LUCASDUDUIT/ECE445/README.md

# ECE445 
A repository to replace the physical lab notebook for ECE445.

## Project Title: **Sturdy Smart Feeder**

### Team Members
Lucas Duduit
\
T'Andra Newby
\
Kevin Shi
