LUCASDUDUIT/ECE445/Notebooks/Lucas/IMG_2218.jpg

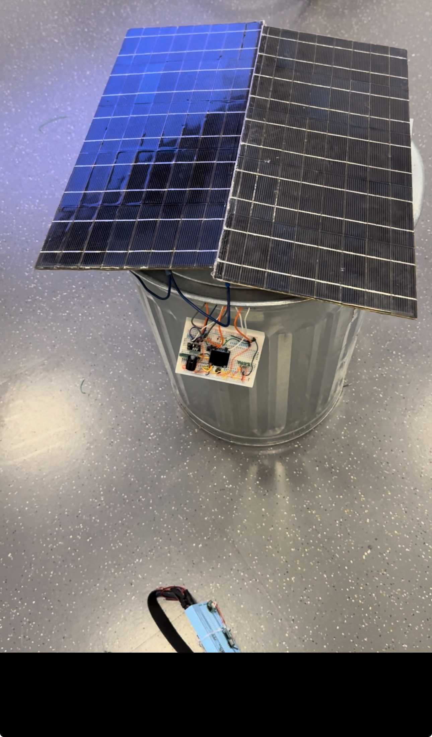
Notebooks/Lucas/IMG_2218.jpg
