LUCASDUDUIT/ECE445/Notebooks/T'Andra/20240418_151749.jpg

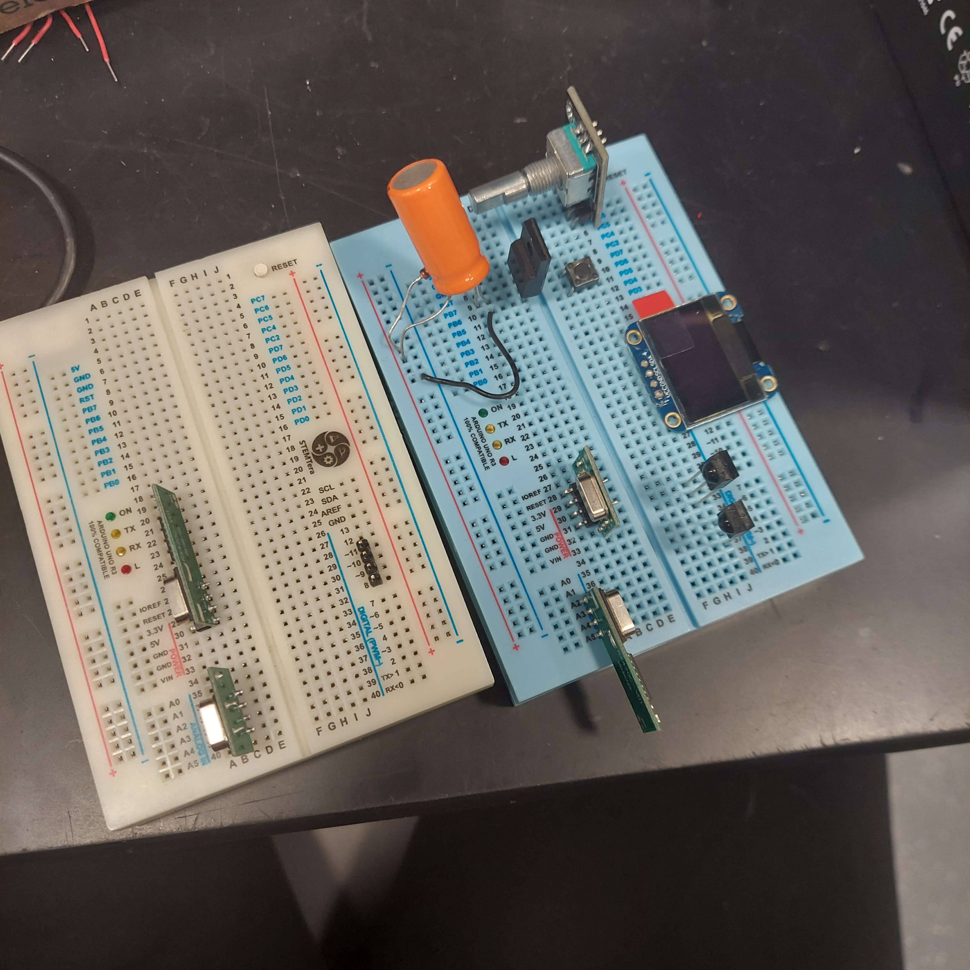
Notebooks/T'Andra/20240418_151749.jpg
