LUCASDUDUIT/ECE445/Notebooks/T'Andra/Screenshot 2024-05-02 122550.png

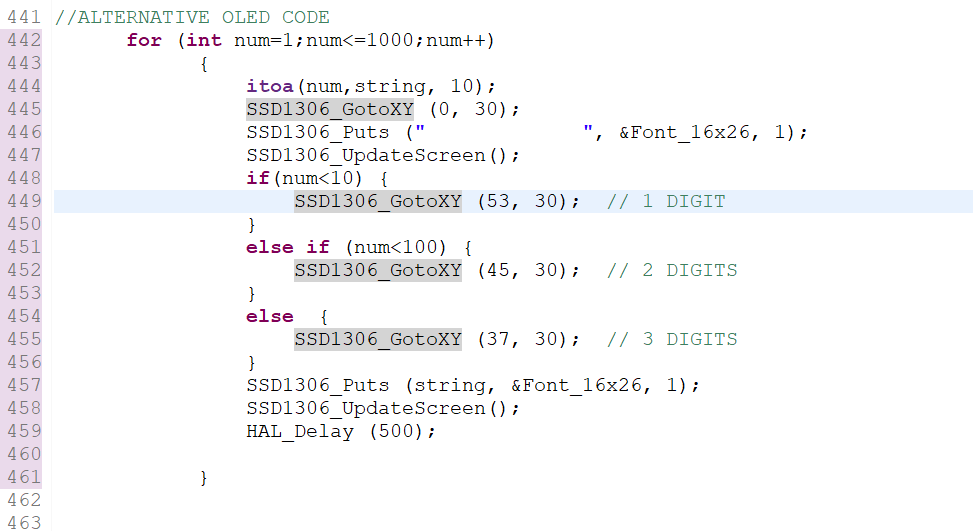
Notebooks/T'Andra/Screenshot 2024-05-02 122550.png
