LUCASDUDUIT/ECE445/Notebooks/T'Andra/practice_nucleo_project/Src/main.c

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
/* Includes ------------------------------------------------------------------*/
#include "main.h"

/* USER CODE BEGIN Includes */
#include <stdio.h>
#include <string.h>
#include <user_set.h>
#include "u8g2.h"
#include "stepper.h"
#include "rfid_feeder_transceiver.h"
#include "stm32f4xx_it.h"
#include "fonts.h"
#include "ssd1306.h"
#include "RH_ASK.h"

/* USER CODE END Includes */

/* USER CODE BEGIN PM */
extern I2C_HandleTypeDef hi2c1;

/* USER CODE END PM */

//I2C_HandleTypeDef hi2c1;

RTC_HandleTypeDef hrtc;

TIM_HandleTypeDef htim1;
TIM_HandleTypeDef htim2;
TIM_HandleTypeDef htim3;

UART_HandleTypeDef huart2;

/* USER CODE BEGIN PV */
//extern uint8_t u8x8_stm32_gpio_and_delay(u8x8_t *u8x8, uint8_t msg, uint8_t arg_int, void *arg_ptr);
//extern uint8_t u8x8_byte_stm32_hw_i2c(u8x8_t *u8x8, uint8_t msg, uint8_t arg_int, void *arg_ptr);
//extern uint8_t u8x8_byte_4wire_hw_i2c(u8x8_t *u8x8, uint8_t msg, uint8_t arg_int, void *arg_ptr);


//static u8g2_t u8g2;


int count, stepNumber, feed_amount, dispense_flag, run_time, run_, empty_flag;
uint8_t set_hour, set_min, init_hour, init_min;
uint8_t door_open_time_hour = 60;
uint8_t door_open_time_min = 60;
uint32_t lastFeederReceiveTime;
int feeding_times[];
int reset_state=0;
int close_flag =0;
int do_not_dispense =0;
int open_door_flag =0;
int run_motor=0;
//int rotationDirection;
//uint8_t TurnsDetected;



/* USER CODE END PV */

void SystemClock_Config(void);
static void MX_GPIO_Init(void);
static void MX_TIM1_Init(void);
static void MX_I2C1_Init(void);
static void MX_RTC_Init(void);
static void MX_TIM2_Init(void);
static void MX_TIM3_Init(void);
static void MX_USART2_UART_Init(void);
/**
  * @brief  The application entry point.
  * @retval int
  */
int main(void)
{
  /* MCU Configuration--------------------------------------------------------*/

  /* Reset of all peripherals, Initializes the Flash interface and the Systick. */
  HAL_Init();

  /* Configure the system clock */
  SystemClock_Config();

  /* Initialize all configured peripherals */
  MX_GPIO_Init();
  MX_TIM1_Init();
  MX_I2C1_Init();
  MX_RTC_Init();
  MX_TIM2_Init();
  MX_TIM3_Init();
  MX_USART2_UART_Init();
  /* USER CODE BEGIN 2 */

 // RH_ASK_Initialization();
  HAL_TIM_PWM_Start(&htim1,TIM_CHANNEL_1);
 // HAL_TIM_Base_Start(&htim1);//TIMER INITIALIZATION FOR THE DELAY ON MICRO SECONDS, stepper code
  HAL_TIM_Encoder_Start(&htim2, TIM_CHANNEL_ALL);//initialization for encoder first example
  HAL_GPIO_WritePin(GPIOA, GPIO_PIN_6, 0);
  HAL_GPIO_WritePin(GPIOA, GPIO_PIN_5, 0);

//stepper init
  HAL_TIM_Base_Start(&htim3);
  stepNumber = 1;




  SSD1306_Init();
  SSD1306_Fill(0); //clear oled
  SSD1306_GotoXY (0,0);
  SSD1306_Puts ("Set Current Time", &Font_7x10, 1);
  SSD1306_UpdateScreen();
  user_set_hour();

  //below is a test to see if return 0; takes us here
  char buffer_test[50];
  sprintf(buffer_test, "%02d:%02d\r\n", set_hour, set_min);
  HAL_UART_Transmit(&huart2, (uint8_t *)buffer_test, strlen(buffer_test), HAL_MAX_DELAY);
  HAL_Delay(1000);

  //take user input and store it in rtc
  RTC_TimeTypeDef time_;
  time_.Hours = set_hour;
  time_.Minutes = set_min;

  //RTC_TimeTypeDef Usertime;
 // Usertime.Hours = set_hour;
//  init_hour= set_hour-1;
 // Usertime.Minutes = set_min;
//  init_min = set_min;
 //HAL_RTC_SetTime(&hrtc, &Usertime, RTC_FORMAT_BIN);




  SSD1306_Fill(0); //clear oled
  SSD1306_GotoXY (0,0);
  SSD1306_Puts ("Meals Per Day", &Font_7x10, 1);
  SSD1306_UpdateScreen();

  user_set_feeding_amount();

  //store hour and mins in a buffer to compare later to RTC(current time) for dispensing
  SSD1306_Fill(0); //clear oled
  SSD1306_GotoXY (0,0);
  SSD1306_Puts ("Set Meal Times", &Font_7x10, 1);
  SSD1306_UpdateScreen();

  int feeding_times[feed_amount*2];
  for(int i=0; i < feed_amount*2; i+=2){
	  user_set_hour();
	  feeding_times[i] = set_hour;
	  feeding_times[i+1] = set_min;

	    sprintf(buffer_test, "%02d :%02d\r\n ", feeding_times[i], feeding_times[i+1]);
	    HAL_UART_Transmit(&huart2, (uint8_t *)buffer_test, strlen(buffer_test), HAL_MAX_DELAY);

  }





  //"run auger until satisfied for amount"
  SSD1306_Fill(0); //clear oled
  SSD1306_GotoXY (0,0);
  SSD1306_Puts ("Run Feeder Until", &Font_7x10, 1);
  SSD1306_GotoXY (0,15);
  SSD1306_Puts ("Amount Satisfied", &Font_7x10, 1);
  SSD1306_UpdateScreen();

  user_run_auger();

  SSD1306_Fill(SSD1306_COLOR_BLACK);
  SSD1306_UpdateScreen();


  sprintf(buffer_test, "%02d\r\n ", run_time);
  HAL_UART_Transmit(&huart2, (uint8_t *)buffer_test, strlen(buffer_test), HAL_MAX_DELAY);
  HAL_Delay(1000);

  HAL_RTC_SetTime(&hrtc, &time_, RTC_FORMAT_BIN);

 //HAL_RTC_SetTime(&hrtc, &Usertime, RTC_FORMAT_BIN);







  /* USER CODE END 2 */

  /* Infinite loop */
  /* USER CODE BEGIN WHILE */
  while (1)
  {



//	  //real time clock code
	 // 	RTC_TimeTypeDef time_;
	  	HAL_RTC_GetTime(&hrtc, &time_, RTC_FORMAT_BIN);

	  	char buffer_test[50];

	  	char buffer[50];
	  	char buffer1[50];

	  	sprintf(buffer1, "%02d:%02d:%02d\r\n", time_.Hours , time_.Minutes, time_.Seconds);
	  	HAL_UART_Transmit(&huart2, (uint8_t *)buffer1, strlen(buffer1), HAL_MAX_DELAY);

	  	sprintf(buffer, "%02d:%02d", time_.Hours, time_.Minutes);

//	  	SSD1306_GotoXY (0, 30);
//	  	SSD1306_Puts ("             ", &Font_11x18, 1);
//	  	SSD1306_UpdateScreen();
		SSD1306_GotoXY (37, 30);
		SSD1306_Puts (buffer, &Font_11x18, 1);
		SSD1306_UpdateScreen();
	  	HAL_Delay(1000);


	  	// DC MOTOR CODE
	  	for(int i=0; i < feed_amount*2; i+=2)
	  	{
		  if(time_.Hours == feeding_times[i])
		  {			  	//char *test = "wont dispense? 1\r\n";

			  if(time_.Minutes == feeding_times[i+1] && !do_not_dispense) //if feeding time is equal and food is not overflown, dispense
			  {

				  run_ = run_time;
				  while(run_ !=0)
				  {
				 	  char *test = "dc motor on\r\n";
				  	  HAL_UART_Transmit(&huart2, (uint8_t *)test, strlen(test), HAL_MAX_DELAY);

				  	  HAL_GPIO_WritePin(GPIOB, GPIO_PIN_4, 1);//sets pb4 to high
				  	  //TIM1->CCR1 = 250;//duty cycle 50 percent, same as	  htim1.Instance->CCR1 = 250;
					  run_--;
					  HAL_Delay(1000);//Delay in ms, 3 seconds


				  }
				  HAL_GPIO_WritePin(GPIOB, GPIO_PIN_4, 0);//turn motor off

//			  	  HAL_GPIO_WritePin(GPIOA, GPIO_PIN_6, 1);//send signal to allow dog to come to feeder and eat
			  	  do_not_dispense =1;

				 // HAL_Delay(45000);
				  break;
			  }
		  }
		  //i++;
	   }

	  	 	 	 	 	 	 if(HAL_GPIO_ReadPin(GPIOA, GPIO_PIN_5) && !close_flag && do_not_dispense ){//if we get a signal back open dog feeder.

	  					 	  	 char *test = "stepper motor open\r\n";
	  					  		 HAL_UART_Transmit(&huart2, (uint8_t *)test, strlen(test), HAL_MAX_DELAY);
	  					  		 run_motor=1;
	  					  		 motorOn();
	  							 stepCV(200,150.0f); // Counter Clockwise 100 steps 150 RPM
	  							 motorOff();
	  	//						 HAL_Delay(1000);
	  						  	//RTC_TimeTypeDef time_for_CLOSE;

	  						  	 HAL_RTC_GetTime(&hrtc, &time_, RTC_FORMAT_BIN);

	  							 door_open_time_hour= time_.Hours;
	  							 door_open_time_min= time_.Minutes;
	  						  	 HAL_GPIO_WritePin(GPIOA, GPIO_PIN_6, 0);//stop transmitting
	  							 close_flag=1;
	  							 open_door_flag = 0;

	  							    	char test_ [10];
	  								    sprintf(test_,"%02d:%02d", door_open_time_hour, door_open_time_min );
	  								    HAL_UART_Transmit(&huart2, (uint8_t *)test_, strlen(test_), HAL_MAX_DELAY);
	  					  }

//  	 	 	 	 	 		 uint8_t diff_mins= time_.Minutes - door_open_time_min;
//
//	  	 	 	 	 	 	 while(diff_mins < 1){
//	  	 	 	 	 	 		 diff_mins= time_.Minutes - door_open_time_min;
//	  	 	 	 	 	 		 if(run_motor){
//	  					  		 motorOn();
//	  							 stepCV(200,150.0f); // Counter Clockwise 100 steps 150
//	  							 motorOff();
//
//	  	 	 	 	 	 	 }
//	  	 	 	 	 	 	 }
	  	 	 	 	 	 	// run_motor=0;

	  	if(close_flag){
		  	uint8_t diff_mins =0;
		  //	HAL_RTC_GetTime(&hrtc, &time_, RTC_FORMAT_BIN);

	  	if(door_open_time_hour == time_.Hours){
	  		char *test = "same hour\r\n";
	  		HAL_UART_Transmit(&huart2, (uint8_t *)test, strlen(test), HAL_MAX_DELAY);

	  	    diff_mins= time_.Minutes - door_open_time_min;
			if(diff_mins >= 1){


			  	char *test = "greater than 1\r\n";
			    HAL_UART_Transmit(&huart2, (uint8_t *)test, strlen(test), HAL_MAX_DELAY);
			    char test_ [10];
			    sprintf(test_,"%02d\r\n", time_.Minutes);
			    HAL_UART_Transmit(&huart2, (uint8_t *)test_, strlen(test_), HAL_MAX_DELAY);

				 motorOn();
				 stepCCV(200,150.0f); // Counter Clockwise 100 steps 150 RPM
				 motorOff();
				  	close_flag=0;
				do_not_dispense = 0;
				run_motor=0;

			}}
	  	else if(door_open_time_hour != time_.Hours){
	  		char *test = "diff hour\r\n";
	  		HAL_UART_Transmit(&huart2, (uint8_t *)test, strlen(test), HAL_MAX_DELAY);

		    	char test_ [10];
			    sprintf(test_,"%02d\r\n", time_.Hours);
			    HAL_UART_Transmit(&huart2, (uint8_t *)test_, strlen(test_), HAL_MAX_DELAY);
	  		diff_mins = (time_.Minutes + (60 - door_open_time_min));
	  		if(diff_mins >= 1){


				    char test_ [10];
					    sprintf(test_,"%02d\r\n", time_.Minutes);
					    HAL_UART_Transmit(&huart2, (uint8_t *)test_, strlen(test_), HAL_MAX_DELAY);

			  		char *test = "greater than 1\r\n";
			  		HAL_UART_Transmit(&huart2, (uint8_t *)test, strlen(test), HAL_MAX_DELAY);

				 motorOn();
				 stepCCV(200,150.0f); // Counter Clockwise 100 steps 150 RPM
				 motorOff();
				  	close_flag=0;
				  	do_not_dispense = 0;
					run_motor=0;




	  		}
	  	}
	  	}


//	  	while(readInfraredDetector_EMPTY()){ //after dispensing, if nothing is detected, flash oled
////	  		flash OLED
//	  		SSD1306_Fill(SSD1306_COLOR_WHITE);
//	  		SSD1306_Fill(SSD1306_COLOR_BLACK);//0
//	  	}


//this is the dc motor, which runs the auger, should only run in one direction
//	  HAL_GPIO_WritePin(GPIOB, GPIO_PIN_4, 1);//sets pb4 to high
//	  TIM1->CCR1 = 250;//duty cycle 50 percent, same as	  htim1.Instance->CCR1 = 250;
//	  HAL_Delay(3000);//Delay in ms, 3 seconds


//ALTERNATIVE STEPPER MOTOR CODE
//	  	 motorOn();
//	     stepCV(200,150.0f); // Clockwise 200 steps 150 RPM
//	     motorOff();
//	     HAL_Delay(2000);
//
//	     motorOn();
//	     stepCCV(200,150.0f); // Counter Clockwise 100 steps 150 RPM
//	     motorOff();
//	     HAL_Delay(2000);




//OLED CODE
//	u8g2_FirstPage(&u8g2);
//	do
//	{
//		 u8g2_SetFont(&u8g2, u8g2_font_ncenB14_tr);
//		 u8g2_DrawStr(&u8g2, 0, 15, "Set Time");
//		 u8g2_DrawCircle(&u8g2, 64, 40, 10, U8G2_DRAW_ALL);
//	} while (u8g2_NextPage(&u8g2));

//ALTERNATIVE OLED CODE
//	  for (int num=1;num<=1000;num++)
//	  		{
//	  			itoa(num,string, 10);
//	  			SSD1306_GotoXY (0, 30);
//	  			SSD1306_Puts ("             ", &Font_16x26, 1);
//	  			SSD1306_UpdateScreen();
//	  			if(num<10) {
//	  				SSD1306_GotoXY (53, 30);  // 1 DIGIT
//	  			}
//	  			else if (num<100) {
//	  				SSD1306_GotoXY (45, 30);  // 2 DIGITS
//	  			}
//	  			else  {
//	  				SSD1306_GotoXY (37, 30);  // 3 DIGITS
//	  			}
//	  			SSD1306_Puts (string, &Font_16x26, 1);
//	  			SSD1306_UpdateScreen();
//	  			HAL_Delay (500);
//
//	  		}


//IR SENSOR CODE
//  // Turn on SEN-18772 (IR emitter)
//	controlInfraredEmitter(1);
//
//	//Read SEN-19018 (IR detector)
//	uint8_t detection = readInfraredDetector();
//
//	// Your code logic here based on the detection result
// 		if(detection){
// 			//stop dispensing until ir detects nothing
//				 motorOff();
//				 HAL_Delay(2000);
// 		}
// //Delay for a short period to avoid reading too frequently
//	HAL_Delay(1000); // Adjust delay as needed


//PUSH BUTTON CODE
//HAL_GPIO_ReadPin(SELECT_BUTTON_GPIO_Port, SELECT_BUTTON_Pin)



// ROTARY ENCODER CODE
//
//char buffer_encoder[50];
//if(TurnsDetected){
//  TurnsDetected = 0;
//  if(rotationDirection){
//	  count+=1;
//  }
//
//  else if(!rotationDirection){
//	  count-=1;
//
//  }
//}
//sprintf(buffer_encoder, "%02d:%02d \r\n", count, 00);
//HAL_UART_Transmit(&huart2, (uint8_t *)buffer_encoder, strlen(buffer_encoder), HAL_MAX_DELAY);
//HAL_Delay(1000);


	 // HAL_GPIO_WritePin(GPIOA, GPIO_PIN_6, 0);

	  //TransmitRange();

	  //HAL_GPIO_WritePin(GPIOA, GPIO_PIN_6, 0);

//	  if(HAL_GPIO_ReadPin(GPIOA,GPIO_PIN_5)){
		 // CheckReceive();
//	  }

//	  if((HAL_GetTick() - lastFeederReceiveTime) >= 30000) {
//		  //add stepper motor code that closes feeder
//		 motorOn();
//		 stepCCV(200,150.0f); // Counter Clockwise 100 steps 150 RPM
//		 motorOff();
//		 HAL_Delay(1000);
//	  }




    /* USER CODE END WHILE */

    /* USER CODE BEGIN 3 */
  }
  /* USER CODE END 3 */
}

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
/* USER CODE BEGIN 4 */



/**
  * @brief  Period elapsed callback in non-blocking mode
  * @param  htim TIM handle
  * @retval None
  */
//void HAL_TIM_PeriodElapsedCallback(TIM_HandleTypeDef *htim)
//{
//	RH_HandleTimerInterrupt_16KHz();
////	g_timerCount++;
//}

// Function to control SEN-18772 (IR emitter)
//void controlInfraredEmitter(int state) {
//    HAL_GPIO_WritePin(IR_EMITTER_GPIO_Port, IR_EMITTER_Pin, state ? GPIO_PIN_SET : GPIO_PIN_RESET);
//}
//
//// Function to read SEN-19018 (IR detector)
//int readInfraredDetector() {
//    return HAL_GPIO_ReadPin(IR_DETECTOR_GPIO_Port, IR_DETECTOR_Pin);
//}
//
//void controlInfraredEmitter_EMPTY(int state) {
//    HAL_GPIO_WritePin(IR_EMITTER_EMPTY_GPIO_Port, IR_EMITTER_EMPTY_Pin, state ? GPIO_PIN_SET : GPIO_PIN_RESET);
//}
//
//// Function to read SEN-19018 (IR detector)
//int readInfraredDetector_EMPTY() {
//    return HAL_GPIO_ReadPin(IR_DETECTOR_EMPTY_GPIO_Port, IR_DETECTOR_EMPTY_Pin);
//}

void HAL_GPIO_EXTI_Callback(uint16_t GPIO_Pin)
{
	//HAL_GPIO_TogglePin(GPIOA, GPIO_PIN_5);
}
//int user_reset(){
//		  SSD1306_Fill(0); //clear oled
//	  	  SSD1306_GotoXY (0,0);
//	  	  SSD1306_Puts ("Set Current Time", &Font_7x10, 1);
//	  	  user_set_hour();
//
//	  	  char buffer_test[50];
//	  	  sprintf(buffer_test, "%02d:%02d\r\n", set_hour, set_min);
//	  	  HAL_UART_Transmit(&huart2, (uint8_t *)buffer_test, strlen(buffer_test), HAL_MAX_DELAY);
//	  	  HAL_Delay(1000);
//
//	  	  //take user input and store it in rtc
//	  	  RTC_TimeTypeDef userTime;
//	  	  userTime.Hours = set_hour+1;
//	  	  userTime.Minutes = set_min;
//	  	  HAL_RTC_SetTime(&hrtc, &userTime, RTC_FORMAT_BIN);
//
//	  	  user_set_feeding_amount();
//
//	  	  //store hour and mins in a buffer to compare later to RTC(current time) for dispensing
//	  	  SSD1306_Fill(0); //clear oled
//	  	  SSD1306_GotoXY (0,0);
//	  	  SSD1306_Puts ("Set Meal Times", &Font_7x10, 1);
//	  	 // SSD1306_UpdateScreen();
//
//	  	  int feeding_times[feed_amount*2];
//		  for(int i=0; i < feed_amount; i++){
//		  user_set_hour();
//		  feeding_times[i] = set_hour;
//		  feeding_times[i+1] = set_min;
//
//			sprintf(buffer_test, "%02d %02d\r\n ", feeding_times[i], feeding_times[i+1]);
//			HAL_UART_Transmit(&huart2, (uint8_t *)buffer_test, strlen(buffer_test), HAL_MAX_DELAY);
//
//			HAL_Delay(1000);
//
//
//	  	  }
//	  	  user_run_auger();
//
//	  	  SSD1306_Fill(SSD1306_COLOR_BLACK);
//	  	  SSD1306_UpdateScreen();
//
//
//	  	  sprintf(buffer_test, "%02d\r\n ", run_time);
//	  	  HAL_UART_Transmit(&huart2, (uint8_t *)buffer_test, strlen(buffer_test), HAL_MAX_DELAY);
//	  	  HAL_Delay(1000);
//
//	  	  reset_state=0;
//	  	  return 0;
//}

/* USER CODE END 4 */
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
