LUCASDUDUIT/ECE445/Notebooks/T'Andra/practice_nucleo_project/Inc/main.h

#define B1_Pin GPIO_PIN_13
#define B1_GPIO_Port GPIOC
#define B1_EXTI_IRQn EXTI15_10_IRQn
#define ENCODER_DT_Pin GPIO_PIN_0
#define ENCODER_DT_GPIO_Port GPIOC
#define ENCODER_DT_EXTI_IRQn EXTI0_IRQn
#define ENCODER_CLK_Pin GPIO_PIN_1
#define ENCODER_CLK_GPIO_Port GPIOC
#define ENCODER_CLK_EXTI_IRQn EXTI1_IRQn
#define USART_TX_Pin GPIO_PIN_2
#define USART_TX_GPIO_Port GPIOA
#define USART_RX_Pin GPIO_PIN_3
#define USART_RX_GPIO_Port GPIOA
#define RECEIVE_Pin GPIO_PIN_5
#define RECEIVE_GPIO_Port GPIOA
#define TRANSMIT_Pin GPIO_PIN_6
#define TRANSMIT_GPIO_Port GPIOA
#define IN0_Pin GPIO_PIN_0
#define IN0_GPIO_Port GPIOB
#define IN1_Pin GPIO_PIN_1
#define IN1_GPIO_Port GPIOB
#define IN2_Pin GPIO_PIN_2
#define IN2_GPIO_Port GPIOB
#define IN3_Pin GPIO_PIN_10
#define IN3_GPIO_Port GPIOB
#define IR_EMITTER_Pin GPIO_PIN_13
#define IR_EMITTER_GPIO_Port GPIOB
#define IR_DETECTOR_Pin GPIO_PIN_14
#define IR_DETECTOR_GPIO_Port GPIOB
#define OLED_DC_Pin GPIO_PIN_7
#define OLED_DC_GPIO_Port GPIOC
#define SELECT_BUTTON_Pin GPIO_PIN_8
#define SELECT_BUTTON_GPIO_Port GPIOC
#define OLED_RST_Pin GPIO_PIN_9
#define OLED_RST_GPIO_Port GPIOC
#define IR_EMITTER_EMPTY_Pin GPIO_PIN_10
#define IR_EMITTER_EMPTY_GPIO_Port GPIOA
#define IR_DETECTOR_EMPTY_Pin GPIO_PIN_11
#define IR_DETECTOR_EMPTY_GPIO_Port GPIOA
#define TMS_Pin GPIO_PIN_13
#define TMS_GPIO_Port GPIOA
#define TCK_Pin GPIO_PIN_14
#define TCK_GPIO_Port GPIOA
#define SWO_Pin GPIO_PIN_3
#define SWO_GPIO_Port GPIOB
