LUCASDUDUIT/ECE445/(notices)

Notices in the files:
Notebooks/T'Andra/practice_nucleo_project/Src/main.c:
Copyright (c) 2024 STMicroelectronics.
All rights reserved.
This software is licensed under terms that can be found in the LICENSE file
